peace-fiacre/FingerScan/Images et vidéo/fingerprint-sensor-3 (1).jpg

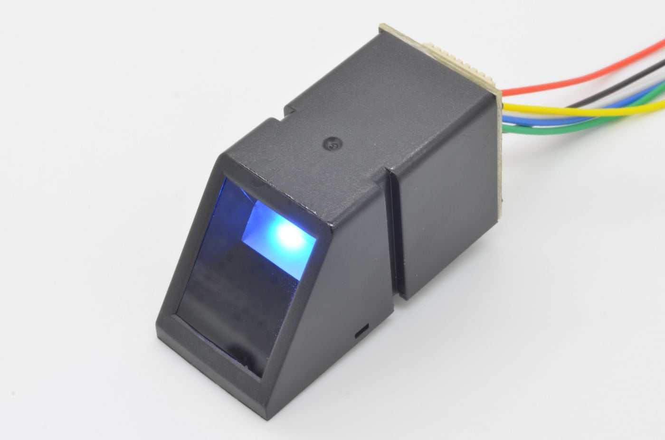
Images et vidéo/fingerprint-sensor-3 (1).jpg
