peace-fiacre/FingerScan/Images et vidéo/WhatsApp Image 2026-09-21 at 1.46.15 PM(1).jpeg

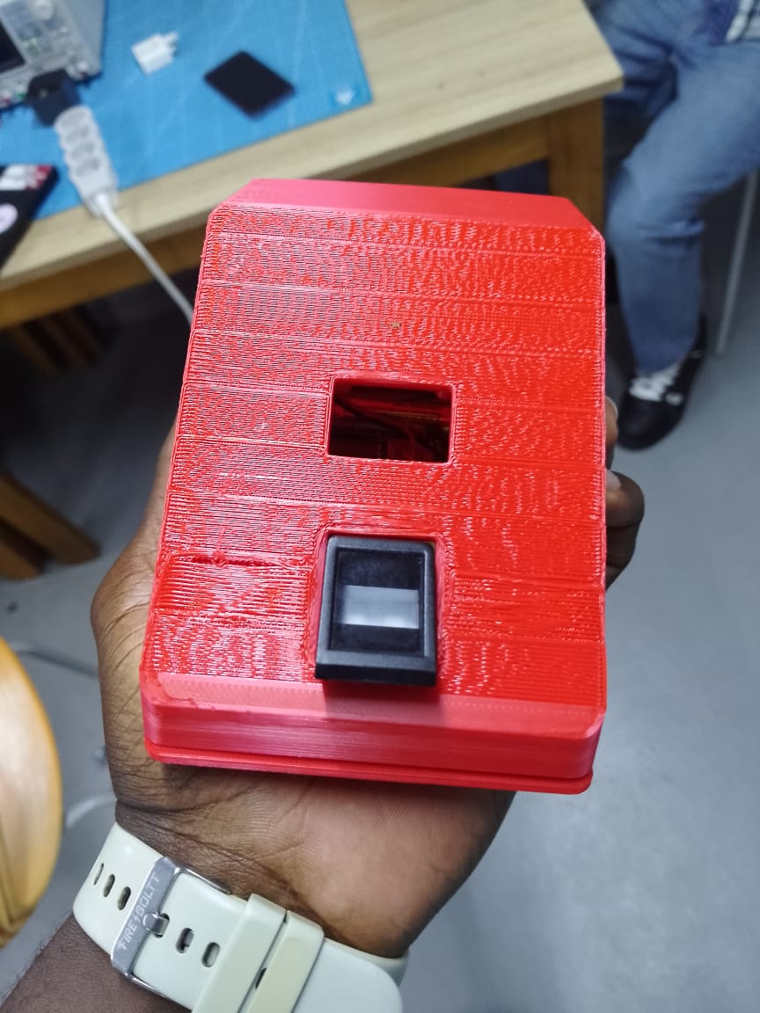
Images et vidéo/WhatsApp Image 2026-09-21 at 1.46.15 PM(1).jpeg
