peace-fiacre/FingerScan/Images et vidéo/WhatsApp Image 2026-09-21 at 2.22.23 PM.jpeg

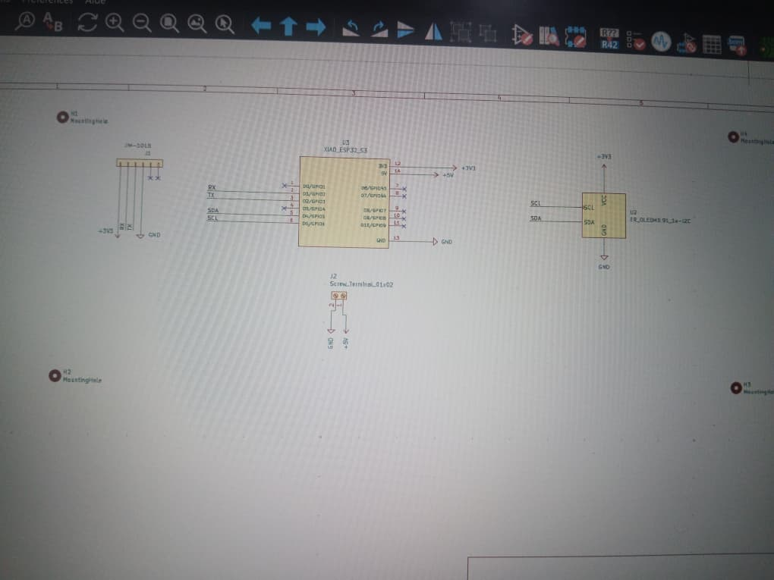
Images et vidéo/WhatsApp Image 2026-09-21 at 2.22.23 PM.jpeg
