peace-fiacre/FingerScan/Fichiers Solidworks et Gcode/Assem1.SLDASM

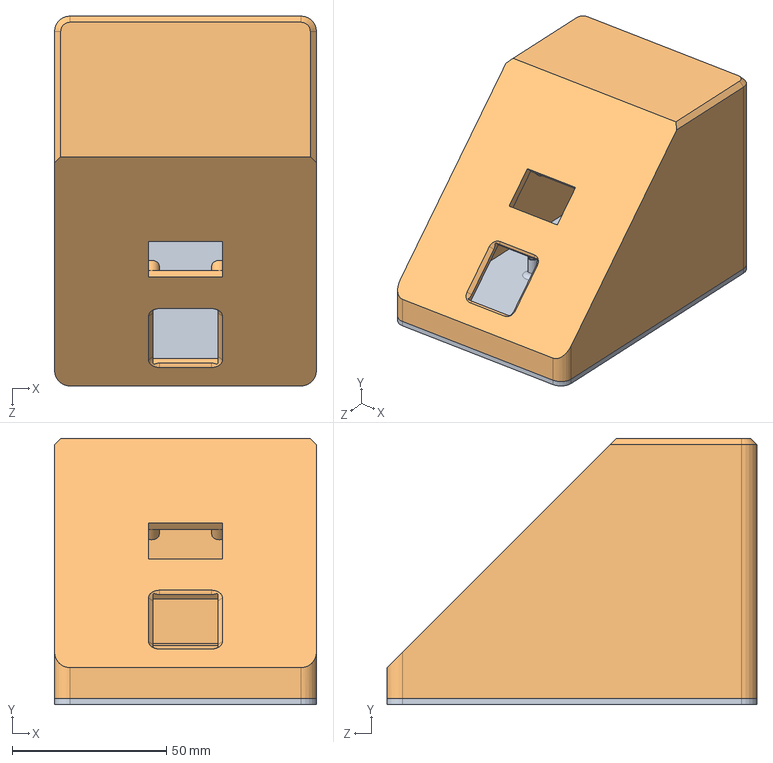
[picture p16: CAD file, 2026-11-12]
Fichiers Solidworks et Gcode/Assem1.SLDASM
85.0 x 86.3 x 120.0 mm
Boitier
Couvercle
