peace-fiacre/FingerScan/Fichiers Solidworks et Gcode/Couvercle.SLDPRT

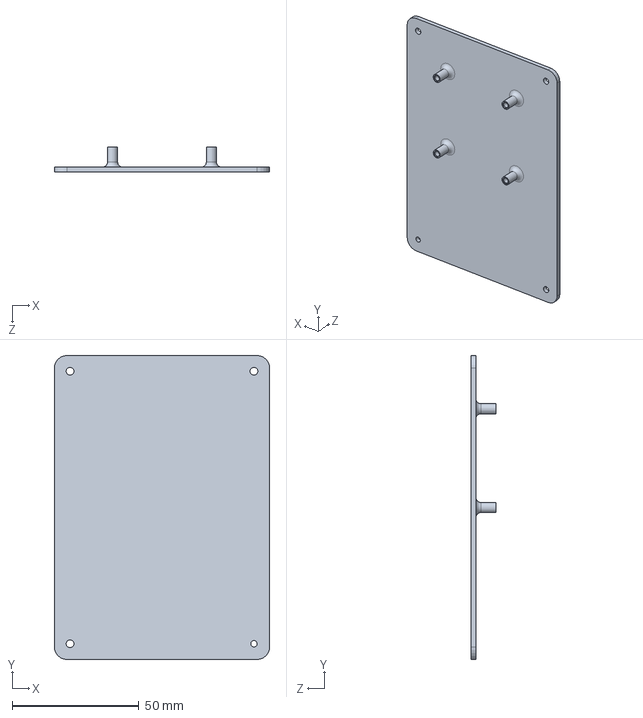
[picture p17: CAD file, 2026-11-12]
Fichiers Solidworks et Gcode/Couvercle.SLDPRT
85.0 x 120.0 x 10.0 mm
