peace-fiacre/FingerScan/Fichiers Solidworks et Gcode/Boitier.SLDPRT

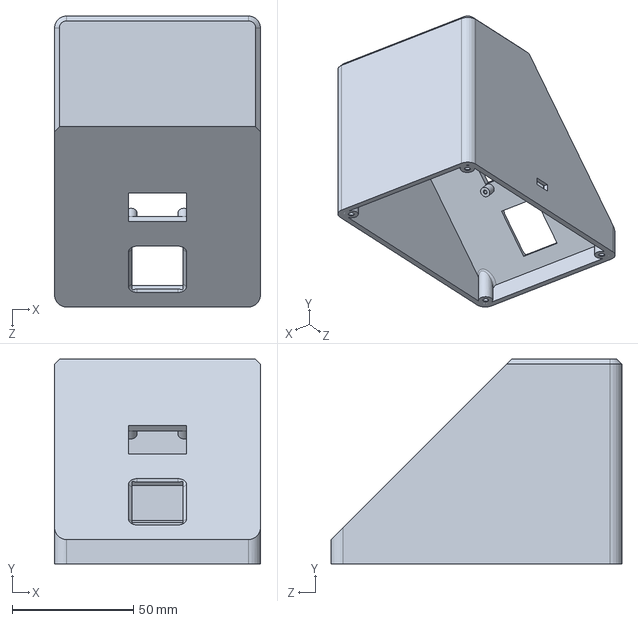
[picture p18: CAD file, 2026-11-12]
Fichiers Solidworks et Gcode/Boitier.SLDPRT
85.0 x 84.3 x 120.0 mm
